AndesRobot-Oficial/Structure-Embedded-Systems_MILO/milo_description/meshes/hoverboard_mainboard_verde.stl

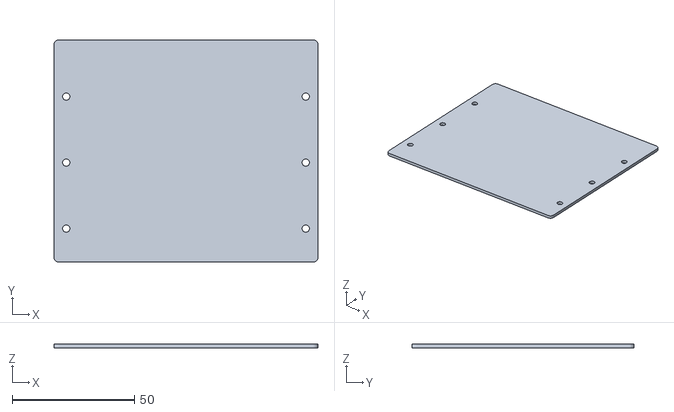
[picture p1: CAD file, 2026-11-08]
milo_description/meshes/hoverboard_mainboard_verde.stl
108.0 x 91.0 x 1.50
