AndesRobot-Oficial/Structure-Embedded-Systems_MILO/milo_description/meshes/hoverboard_mainboard_gris.stl

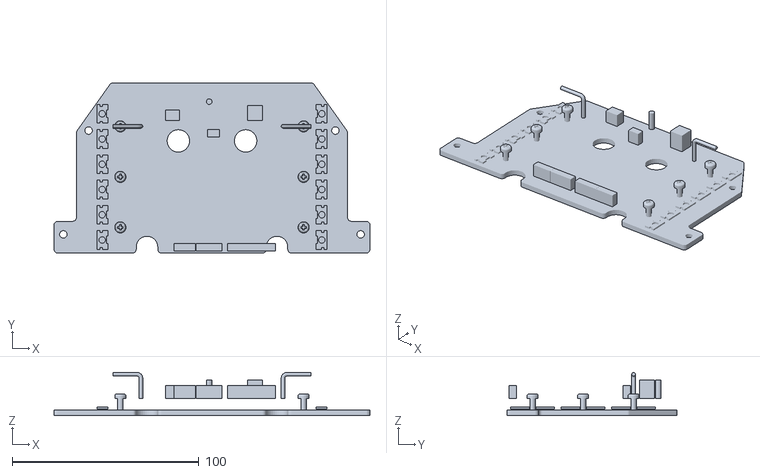
[picture p2: CAD file, 2026-11-08]
milo_description/meshes/hoverboard_mainboard_gris.stl
169.0 x 91.0 x 23.0
