AndesRobot-Oficial/Structure-Embedded-Systems_MILO/milo_description/meshes/hoverboard_mainboard_azul.stl

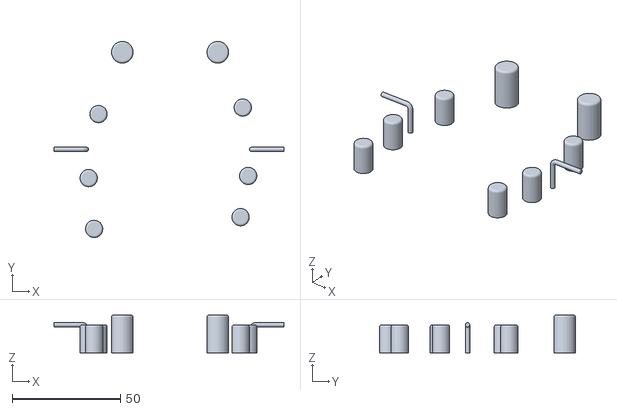
[picture p3: CAD file, 2026-11-08]
milo_description/meshes/hoverboard_mainboard_azul.stl
106.0 x 90.4 x 17.5
