AndesRobot-Oficial/Structure-Embedded-Systems_MILO/milo_description/meshes/hoverboard_mainboard_negro.stl

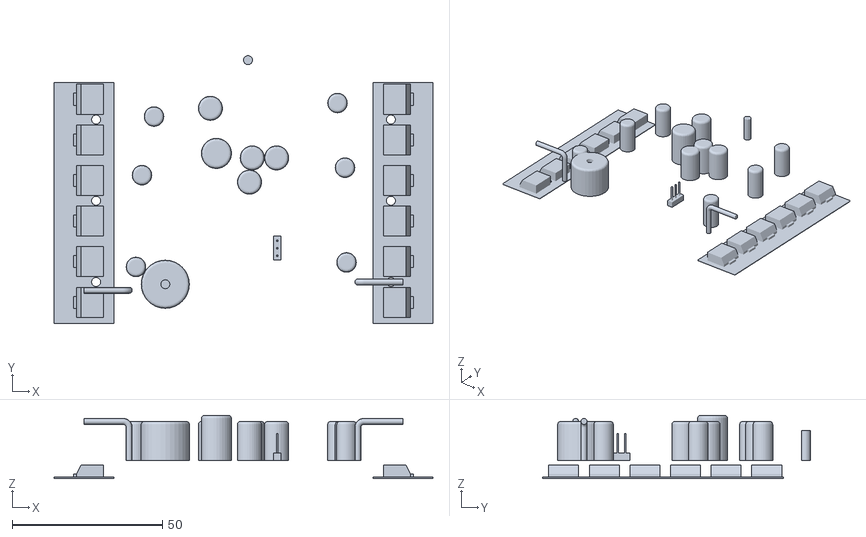
[picture p4: CAD file, 2026-11-08]
milo_description/meshes/hoverboard_mainboard_negro.stl
126.0 x 89.0 x 21.0
