AndesRobot-Oficial/Structure-Embedded-Systems_MILO/milo_description/meshes/cabeza_carcasa.stl

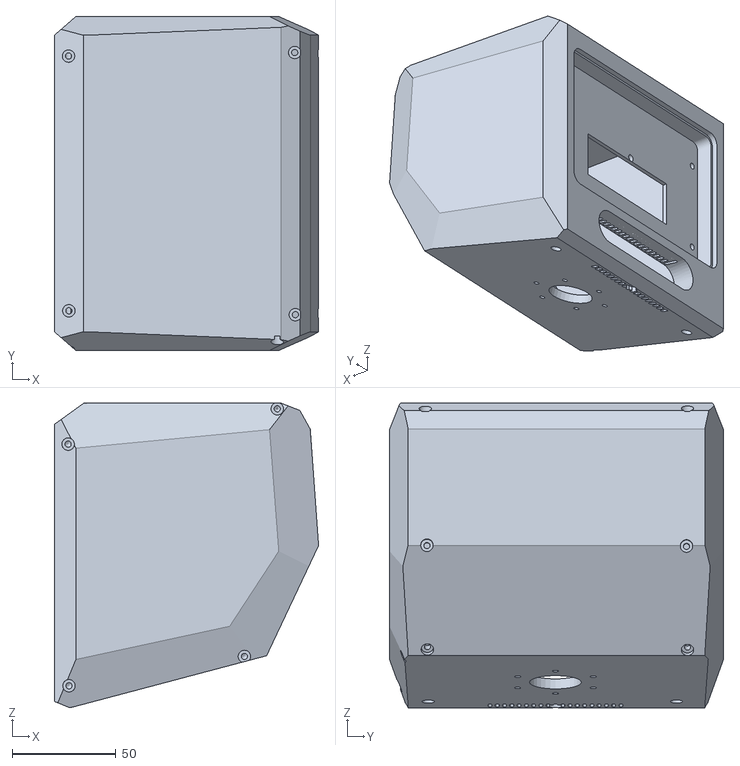
[picture p5: CAD file, 2026-11-08]
milo_description/meshes/cabeza_carcasa.stl
127.1 x 160.7 x 146.6
