AndesRobot-Oficial/Structure-Embedded-Systems_MILO/milo_description/meshes/sk16.stl

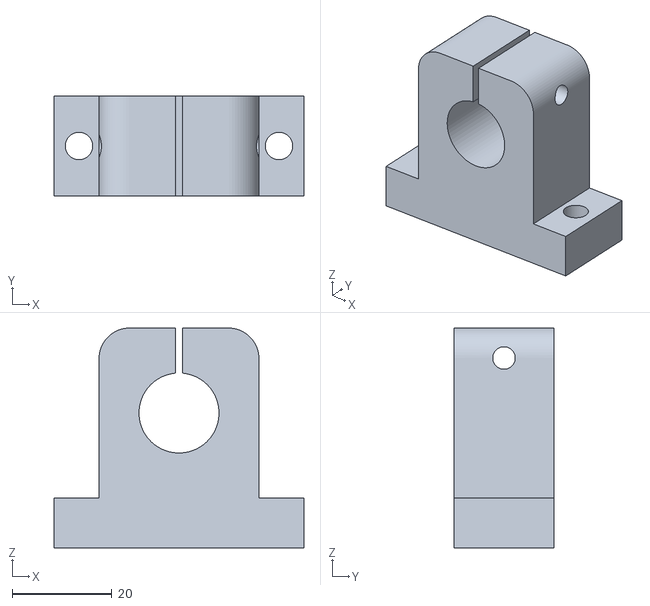
[picture p6: CAD file, 2026-11-08]
milo_description/meshes/sk16.stl
50.0 x 20.0 x 44.0
