AndesRobot-Oficial/Structure-Embedded-Systems_MILO/milo_description/meshes/bateria_izq_dorado.stl

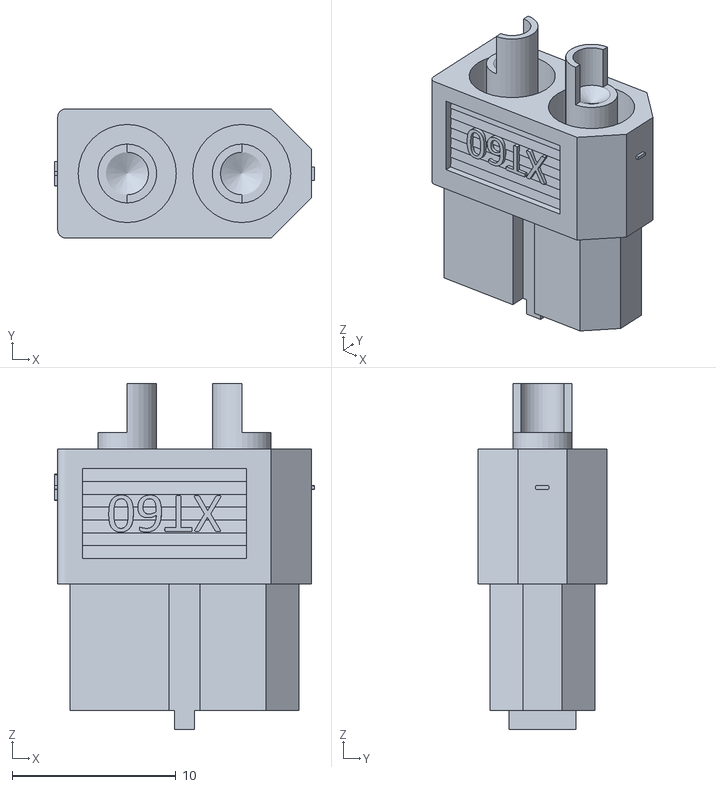
[picture p7: CAD file, 2026-11-08]
milo_description/meshes/bateria_izq_dorado.stl
15.9 x 7.90 x 21.2
