AndesRobot-Oficial/Structure-Embedded-Systems_MILO/milo_description/meshes/bateria_izq_azul.stl

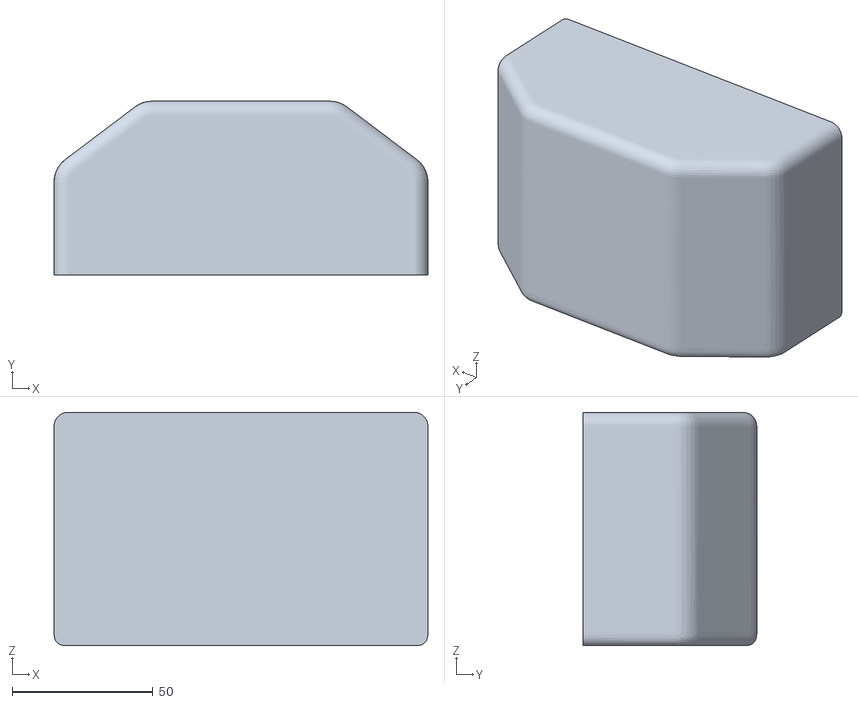
[picture p8: CAD file, 2026-11-08]
milo_description/meshes/bateria_izq_azul.stl
133.0 x 61.8 x 83.0
