AndesRobot-Oficial/Structure-Embedded-Systems_MILO/milo_description/meshes/imu_hfi_b9_cuerpo.stl

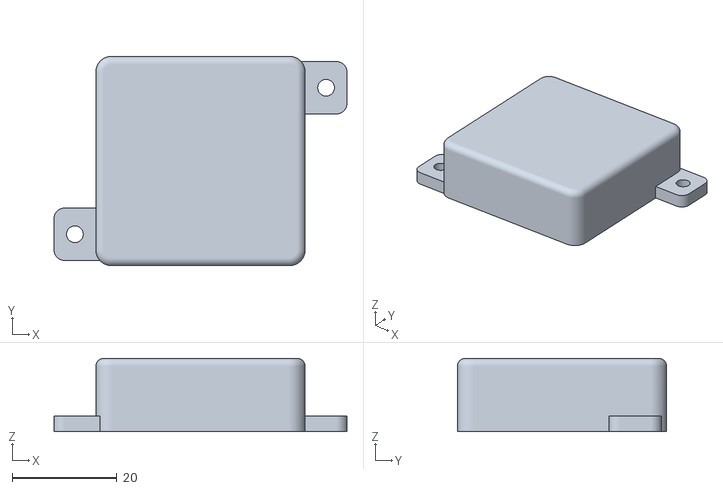
[picture p9: CAD file, 2026-11-08]
milo_description/meshes/imu_hfi_b9_cuerpo.stl
56.0 x 40.0 x 14.0
