AndesRobot-Oficial/Structure-Embedded-Systems_MILO/milo_description/meshes/monitor_soporte.stl

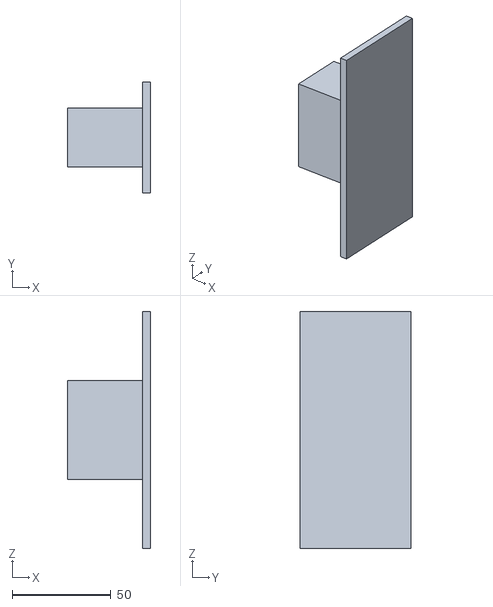
[picture p10: CAD file, 2026-11-08]
milo_description/meshes/monitor_soporte.stl
42.0 x 56.0 x 120.0
