AndesRobot-Oficial/Structure-Embedded-Systems_MILO/milo_description/meshes/arduino_mega_pcb.stl

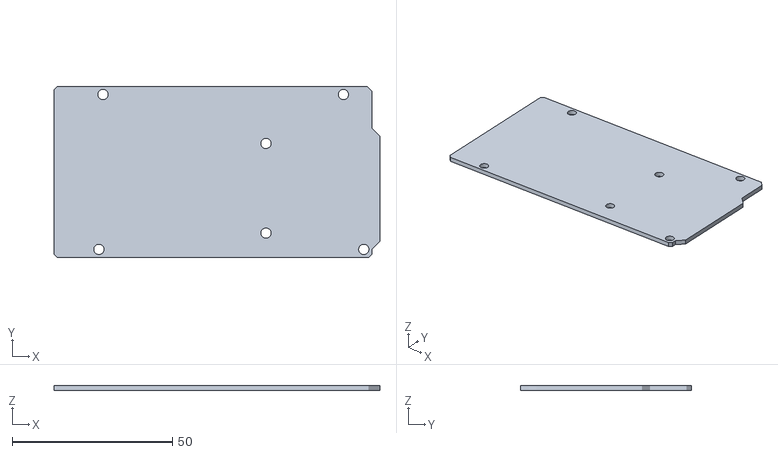
[picture p11: CAD file, 2026-11-08]
milo_description/meshes/arduino_mega_pcb.stl
101.6 x 53.3 x 1.60
