AndesRobot-Oficial/Structure-Embedded-Systems_MILO/milo_description/meshes/bateria_izq_negro.stl

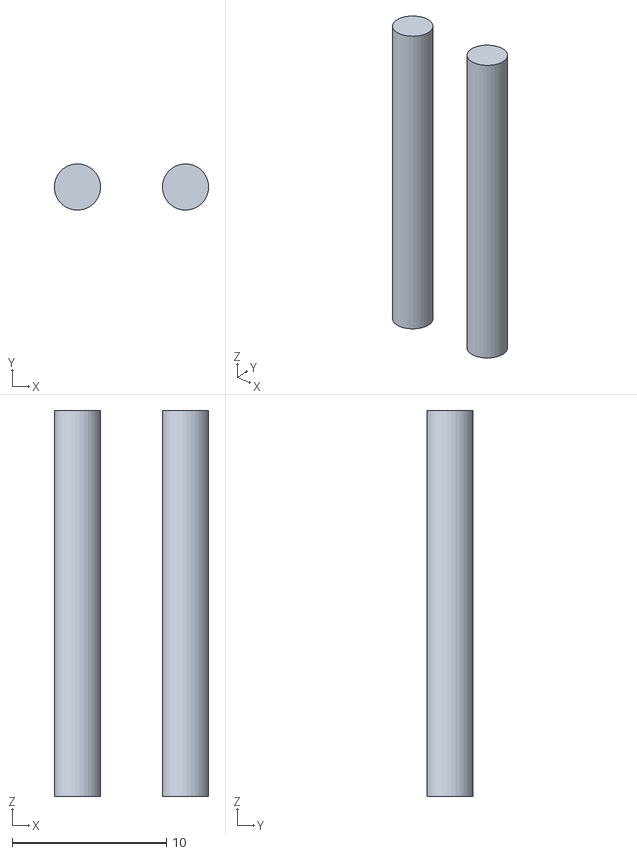
[picture p12: CAD file, 2026-11-08]
milo_description/meshes/bateria_izq_negro.stl
9.99 x 3.00 x 25.0
