AndesRobot-Oficial/Structure-Embedded-Systems_MILO/milo_description/meshes/cabeza_realsense_d435.stl

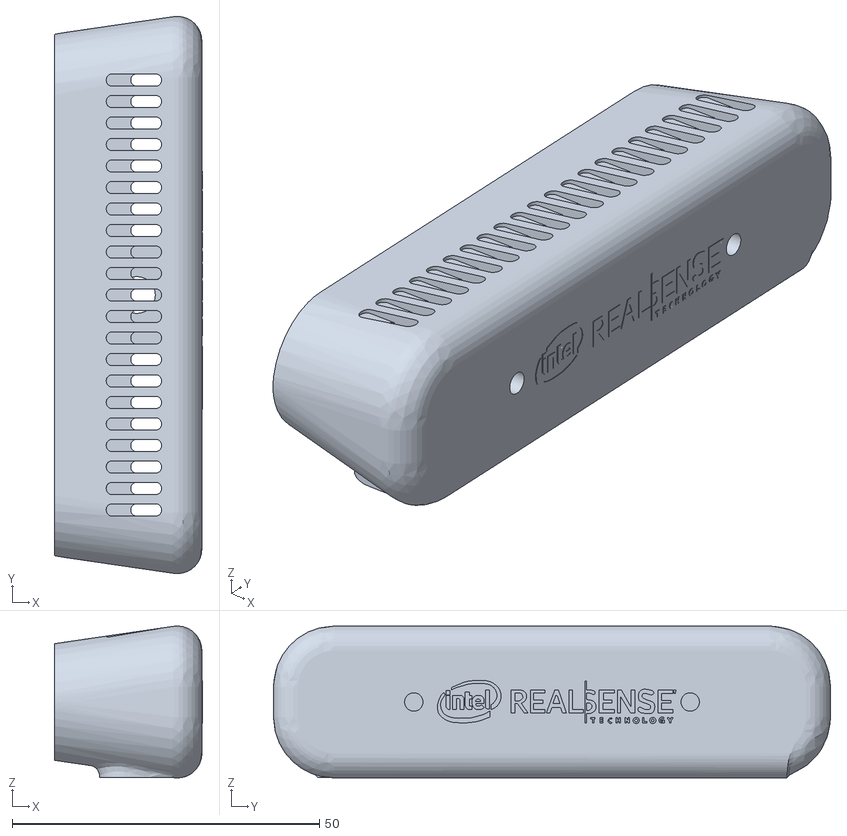
[picture p13: CAD file, 2026-11-08]
milo_description/meshes/cabeza_realsense_d435.stl
24.1 x 90.7 x 24.7
