AndesRobot-Oficial/Structure-Embedded-Systems_MILO/milo_description/meshes/jetson_orin_nano_azul.stl

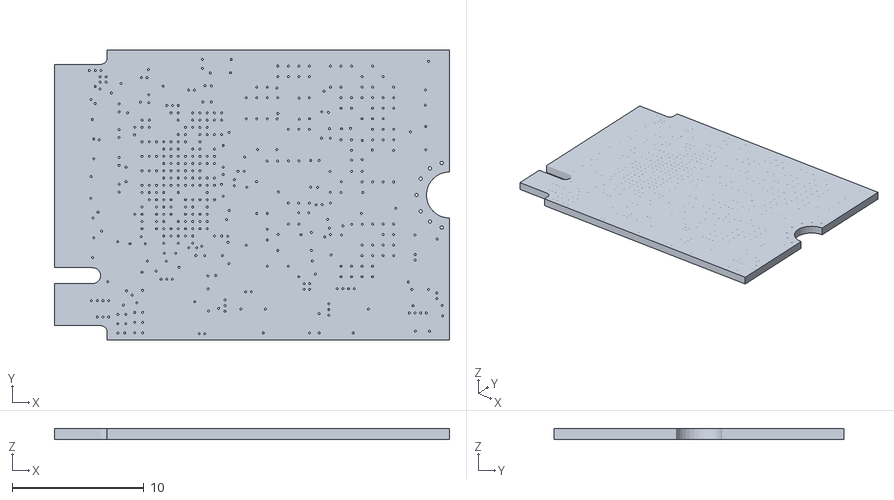
[picture p14: CAD file, 2026-11-08]
milo_description/meshes/jetson_orin_nano_azul.stl
30.0 x 22.0 x 0.8
