AndesRobot-Oficial/Structure-Embedded-Systems_MILO/milo_description/meshes/rueda_loca_nucleo.stl

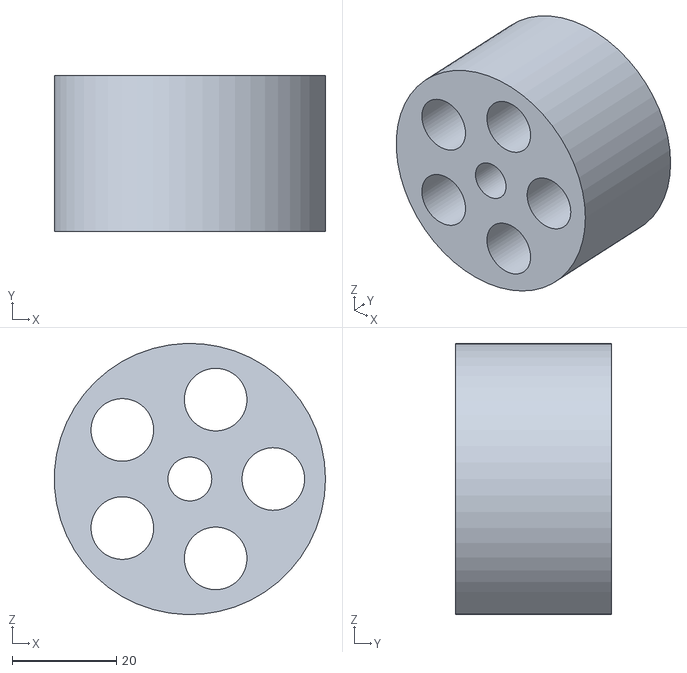
[picture p15: CAD file, 2026-11-08]
milo_description/meshes/rueda_loca_nucleo.stl
52.0 x 30.0 x 52.0
