AndesRobot-Oficial/Structure-Embedded-Systems_MILO/milo_description/meshes/rplidar_c1.stl

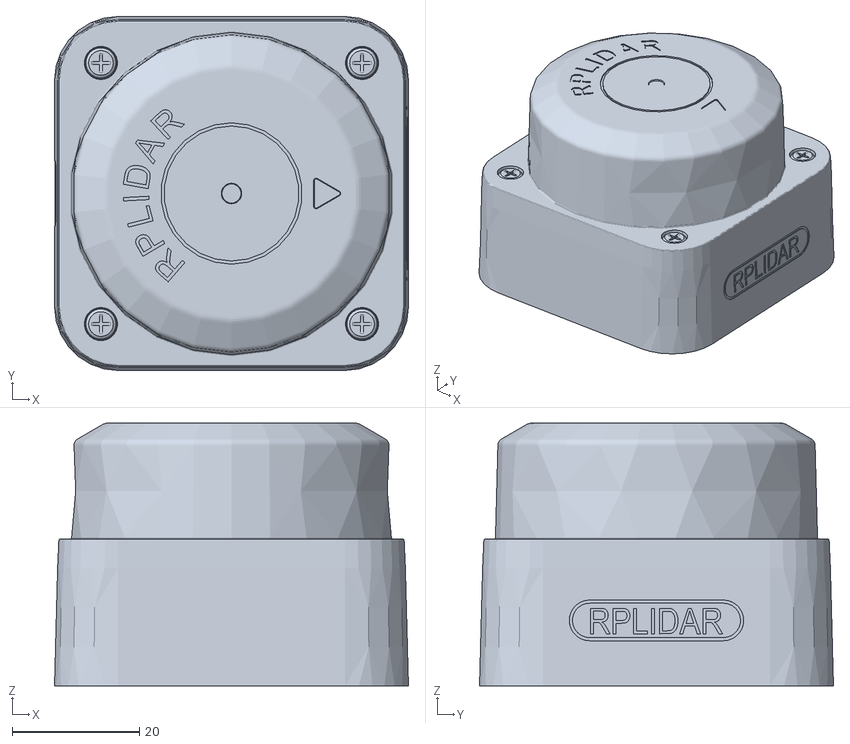
[picture p16: CAD file, 2026-11-08]
milo_description/meshes/rplidar_c1.stl
55.6 x 55.6 x 41.3
