AndesRobot-Oficial/Structure-Embedded-Systems_MILO/milo_description/meshes/rueda_hoverboard_6_5.stl

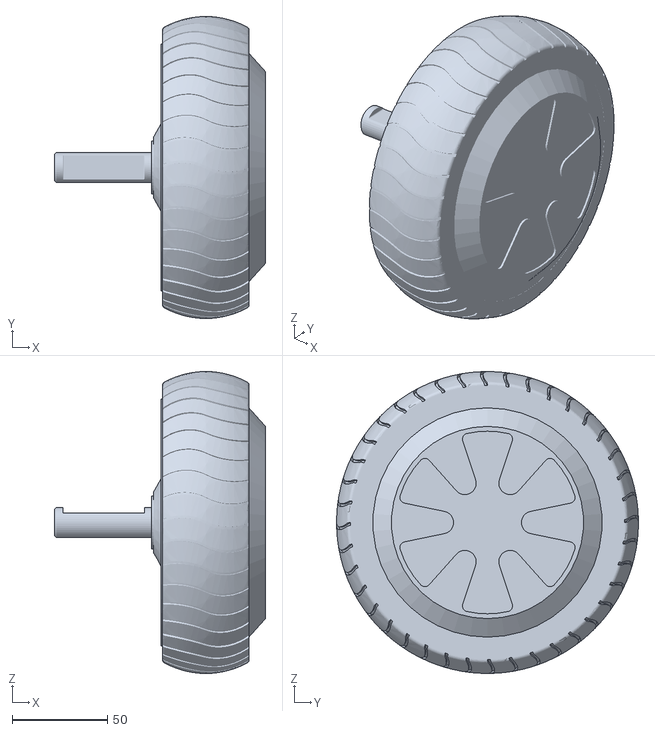
[picture p17: CAD file, 2026-11-08]
milo_description/meshes/rueda_hoverboard_6_5.stl
111.0 x 158.7 x 158.7
