AndesRobot-Oficial/Structure-Embedded-Systems_MILO/milo_description/meshes/tapa_6060.stl

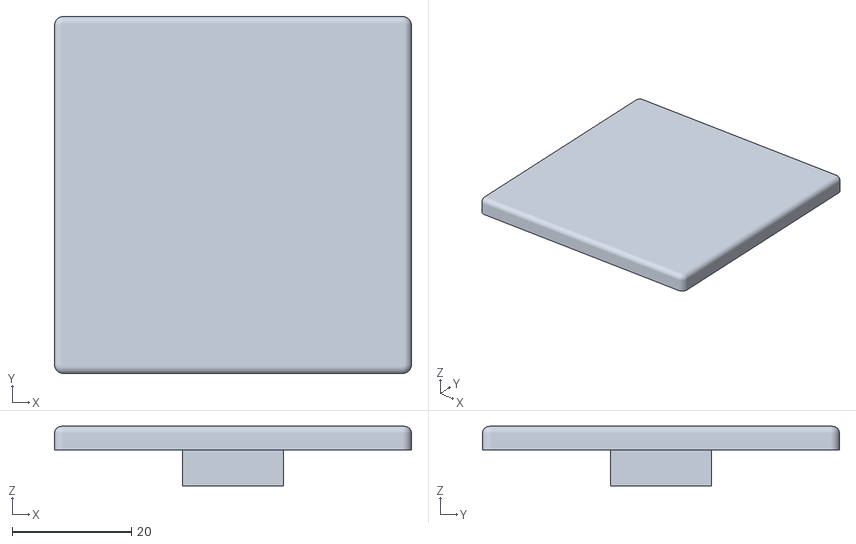
[picture p18: CAD file, 2026-11-08]
milo_description/meshes/tapa_6060.stl
60.0 x 60.0 x 10.0
