AndesRobot-Oficial/Structure-Embedded-Systems_MILO/milo_description/meshes/jetson_orin_nano_gris.stl

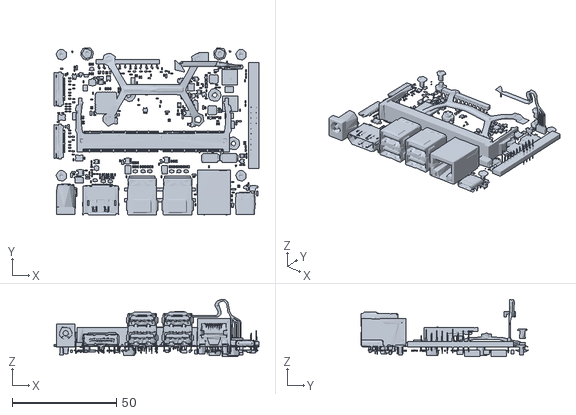
[picture p19: CAD file, 2026-11-08]
milo_description/meshes/jetson_orin_nano_gris.stl
98.2 x 80.1 x 27.5
