AndesRobot-Oficial/Structure-Embedded-Systems_MILO/milo_description/meshes/monitor_cuerpo.stl

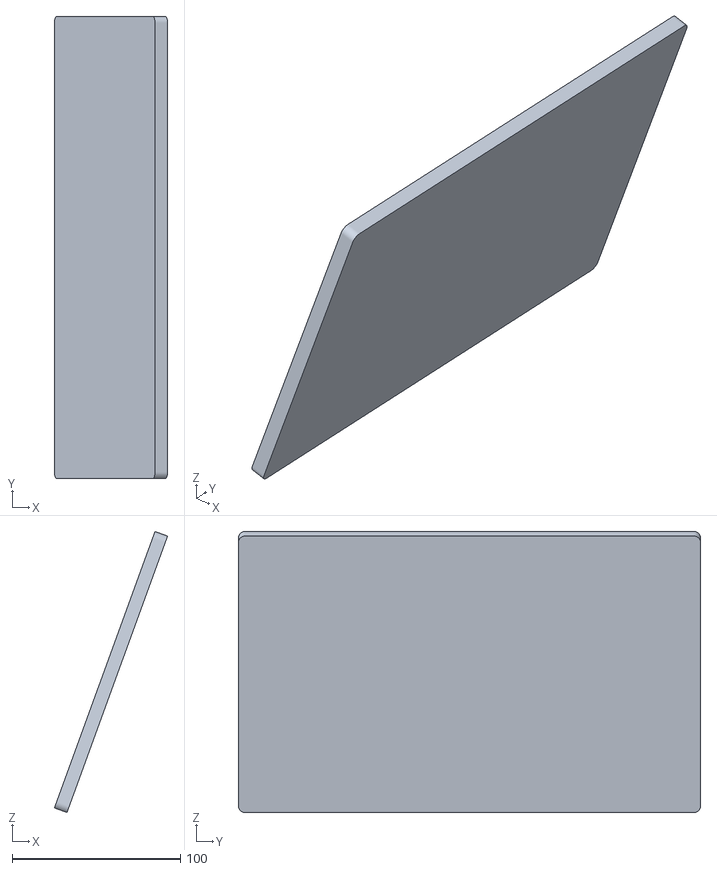
[picture p20: CAD file, 2026-11-08]
milo_description/meshes/monitor_cuerpo.stl
67.4 x 275.0 x 167.2
