AndesRobot-Oficial/Structure-Embedded-Systems_MILO/milo_description/meshes/jetson_orin_nano_verde.stl

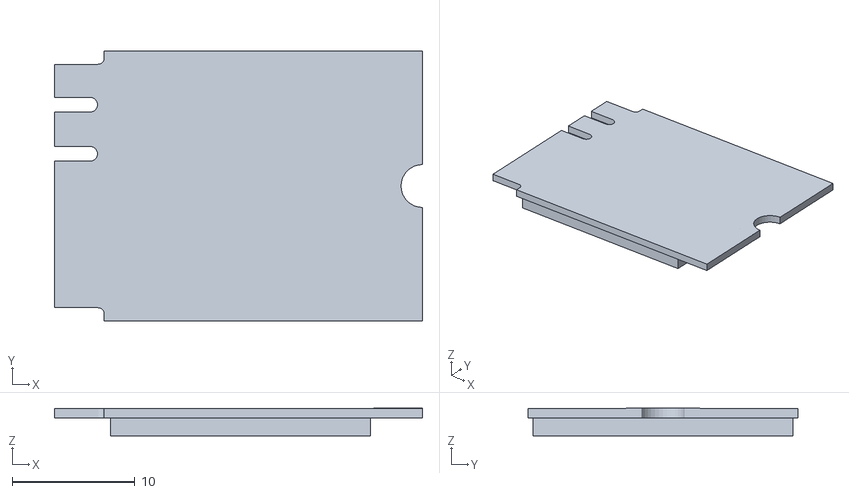
[picture p21: CAD file, 2026-11-08]
milo_description/meshes/jetson_orin_nano_verde.stl
30.0 x 22.0 x 2.26
