AndesRobot-Oficial/Structure-Embedded-Systems_MILO/milo_description/meshes/imu_hfi_b9_conector.stl

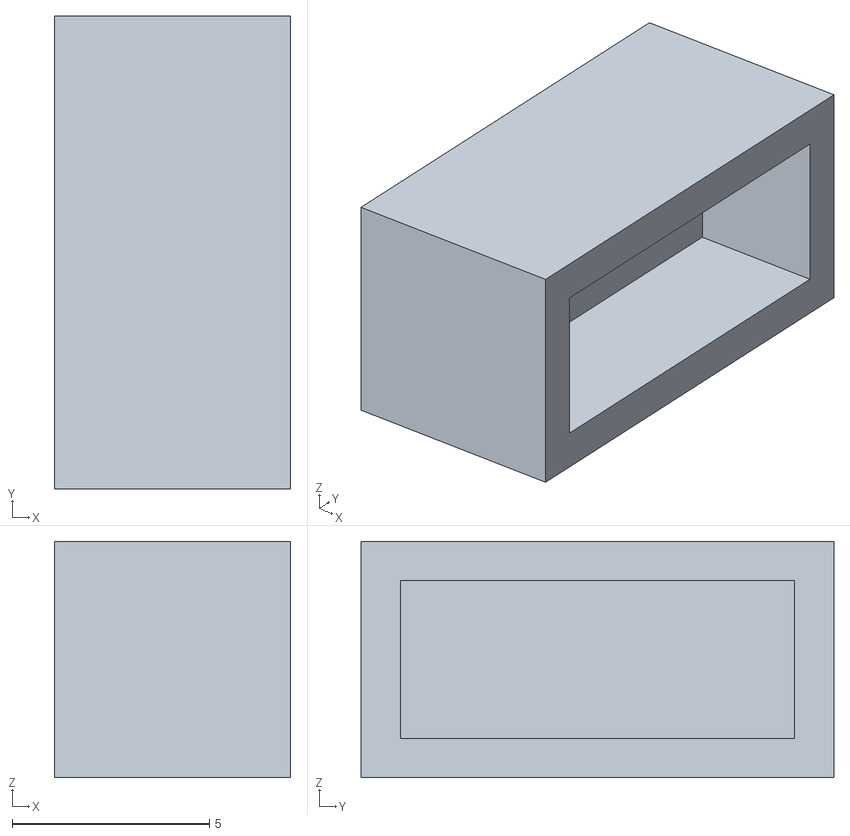
[picture p22: CAD file, 2026-11-08]
milo_description/meshes/imu_hfi_b9_conector.stl
6.00 x 12.0 x 6.00
