AndesRobot-Oficial/Structure-Embedded-Systems_MILO/milo_description/meshes/rueda_loca_acero.stl

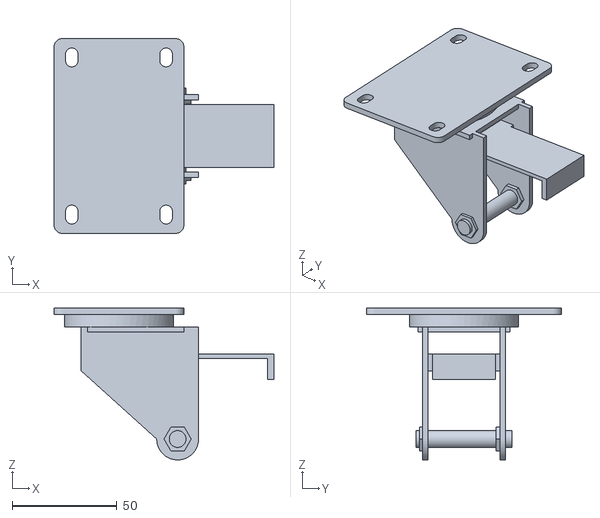
[picture p23: CAD file, 2026-11-08]
milo_description/meshes/rueda_loca_acero.stl
105.0 x 93.0 x 72.5
