AndesRobot-Oficial/Structure-Embedded-Systems_MILO/milo_description/meshes/arduino_mega_negro.stl

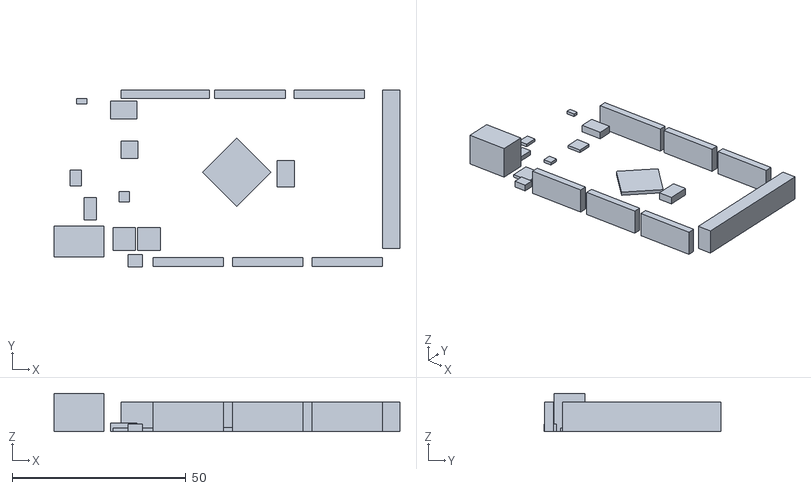
[picture p24: CAD file, 2026-11-08]
milo_description/meshes/arduino_mega_negro.stl
99.6 x 51.1 x 11.0
