AndesRobot-Oficial/Structure-Embedded-Systems_MILO/milo_description/meshes/vslot_6060_1m.stl

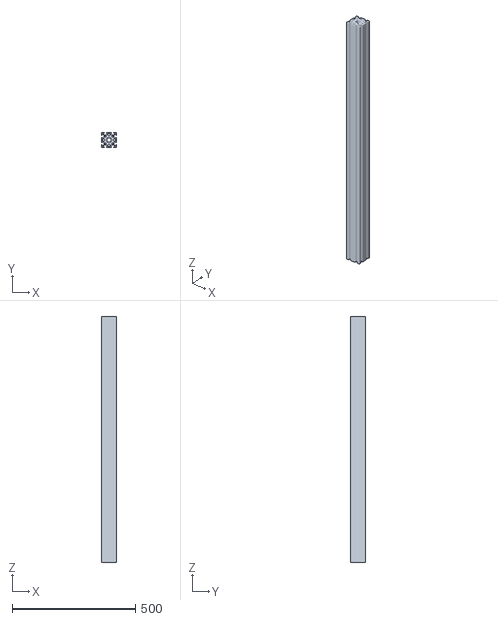
[picture p25: CAD file, 2026-11-08]
milo_description/meshes/vslot_6060_1m.stl
60.0 x 60.0 x 1000.0
