AndesRobot-Oficial/Structure-Embedded-Systems_MILO/milo_description/meshes/monitor_pantalla.stl

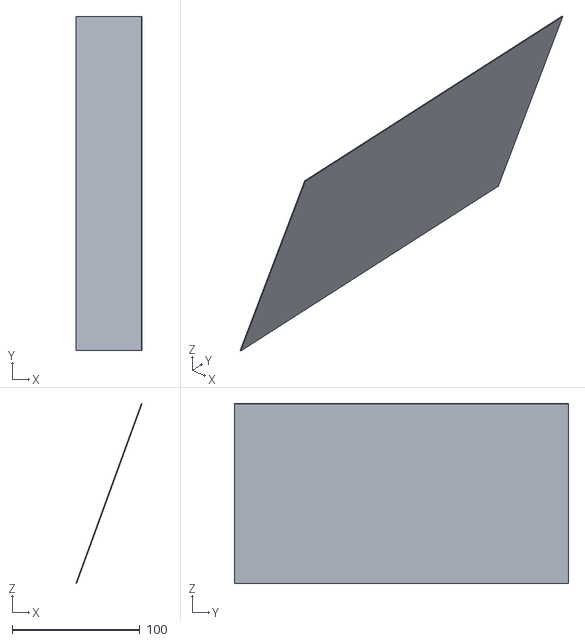
[picture p26: CAD file, 2026-11-08]
milo_description/meshes/monitor_pantalla.stl
51.9 x 262.0 x 141.2
