AndesRobot-Oficial/Structure-Embedded-Systems_MILO/milo_description/meshes/regulador_36v_12v.stl

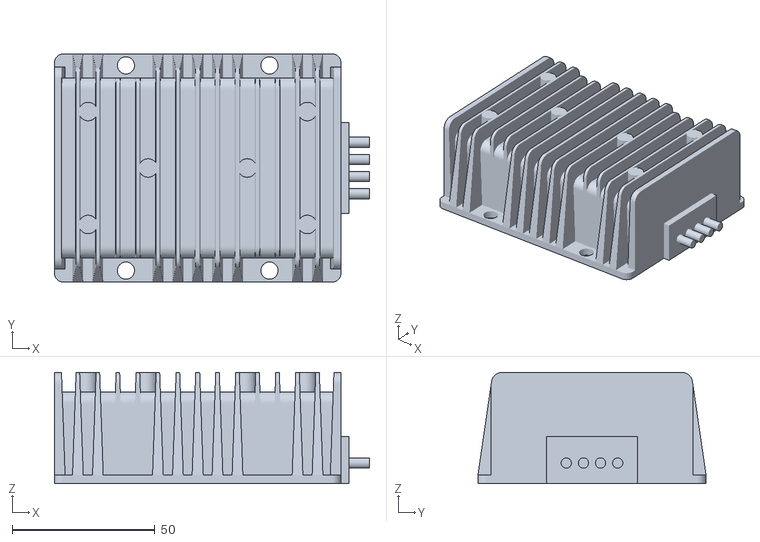
[picture p27: CAD file, 2026-11-08]
milo_description/meshes/regulador_36v_12v.stl
110.2 x 79.8 x 39.0
