AndesRobot-Oficial/Structure-Embedded-Systems_MILO/milo_description/meshes/tb6600_negro.stl

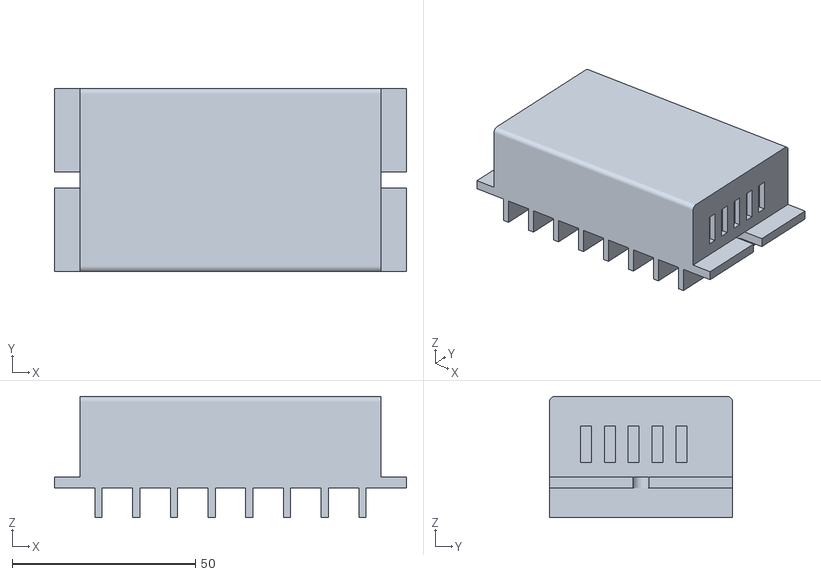
[picture p28: CAD file, 2026-11-08]
milo_description/meshes/tb6600_negro.stl
96.0 x 50.0 x 33.0
