AndesRobot-Oficial/Structure-Embedded-Systems_MILO/milo_description/meshes/rueda_loca_pu.stl

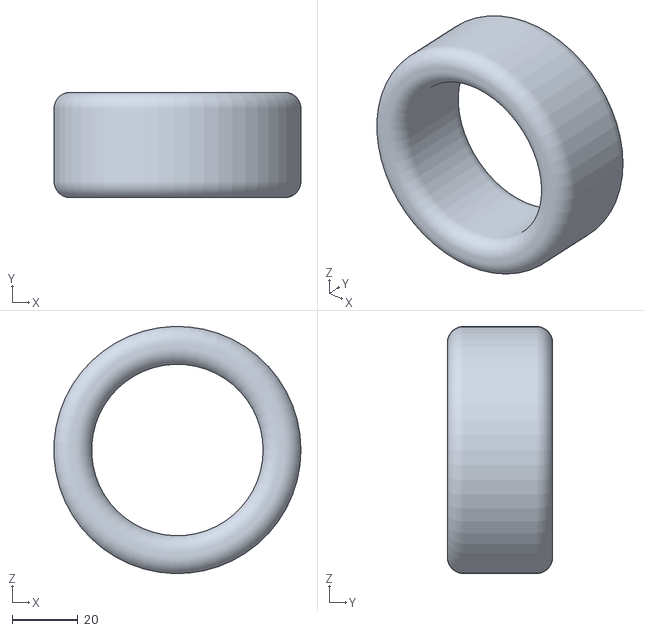
[picture p29: CAD file, 2026-11-08]
milo_description/meshes/rueda_loca_pu.stl
74.9 x 32.0 x 75.0
