AndesRobot-Oficial/Structure-Embedded-Systems_MILO/milo_description/meshes/jetson_orin_nano_negro.stl

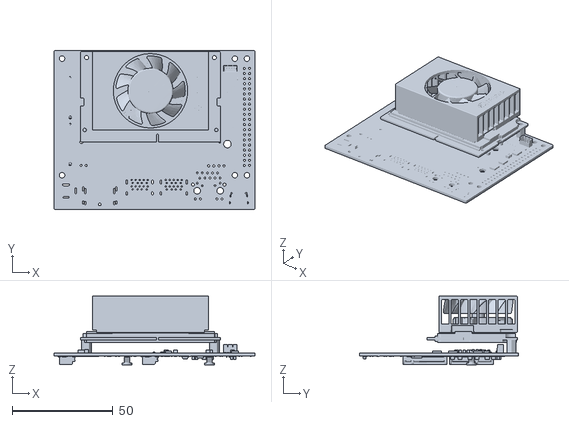
[picture p30: CAD file, 2026-11-08]
milo_description/meshes/jetson_orin_nano_negro.stl
100.0 x 79.0 x 34.2
