AndesRobot-Oficial/Structure-Embedded-Systems_MILO/milo_description/meshes/cabeza_pantalla_vidrio.stl

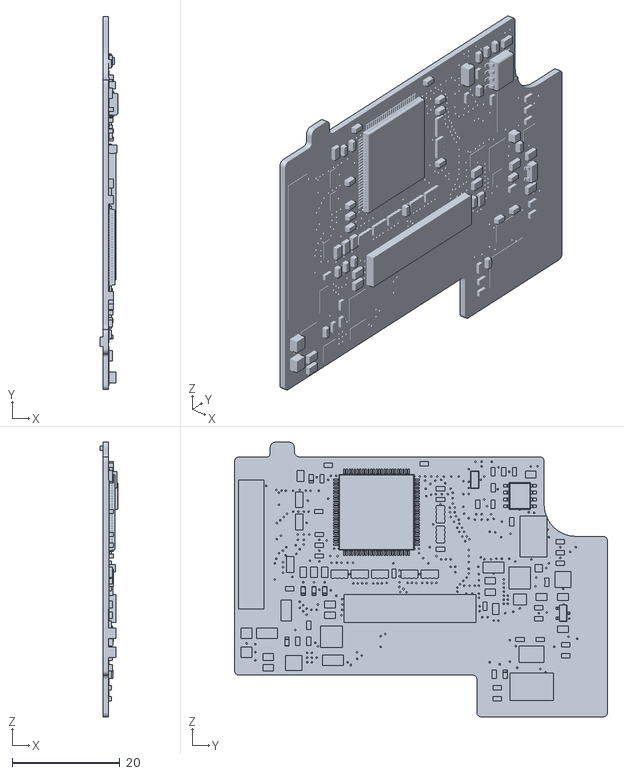
[picture p31: CAD file, 2026-11-08]
milo_description/meshes/cabeza_pantalla_vidrio.stl
3.35 x 69.3 x 51.0
