AndesRobot-Oficial/Structure-Embedded-Systems_MILO/milo_description/meshes/vslot_3030_1m.stl

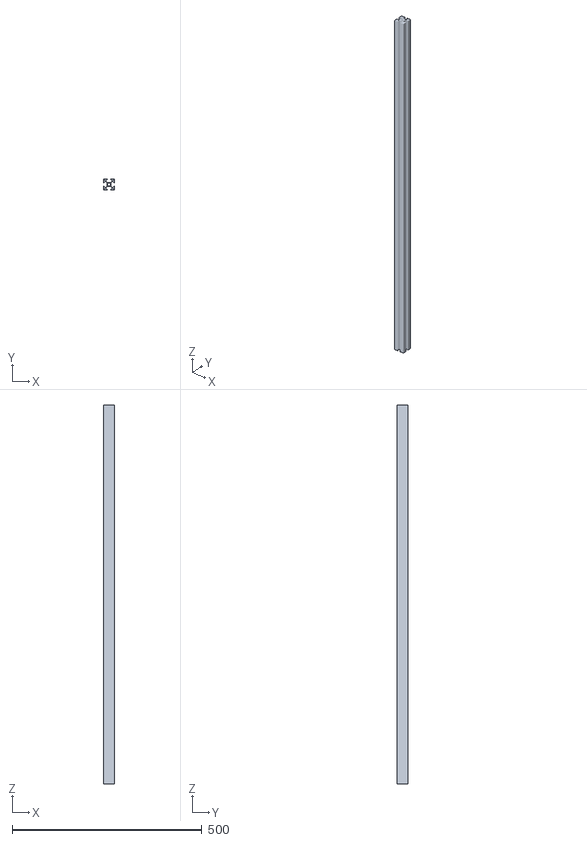
[picture p32: CAD file, 2026-11-08]
milo_description/meshes/vslot_3030_1m.stl
30.0 x 30.0 x 1000.0
