AndesRobot-Oficial/Structure-Embedded-Systems_MILO/milo_description/meshes/tb6600_verde.stl

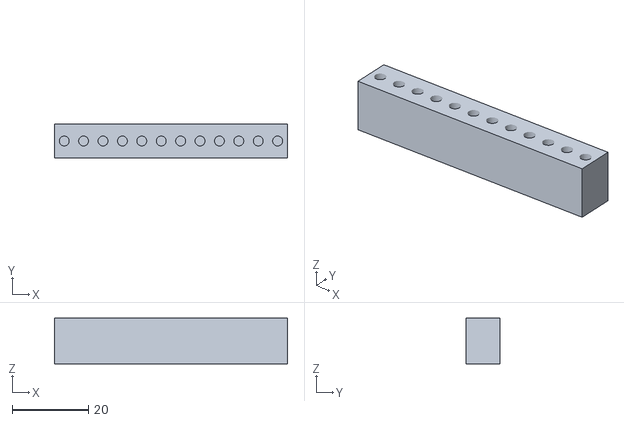
[picture p33: CAD file, 2026-11-08]
milo_description/meshes/tb6600_verde.stl
61.0 x 9.00 x 12.0
