AndesRobot-Oficial/Structure-Embedded-Systems_MILO/milo_description/meshes/tb6600_rojo.stl

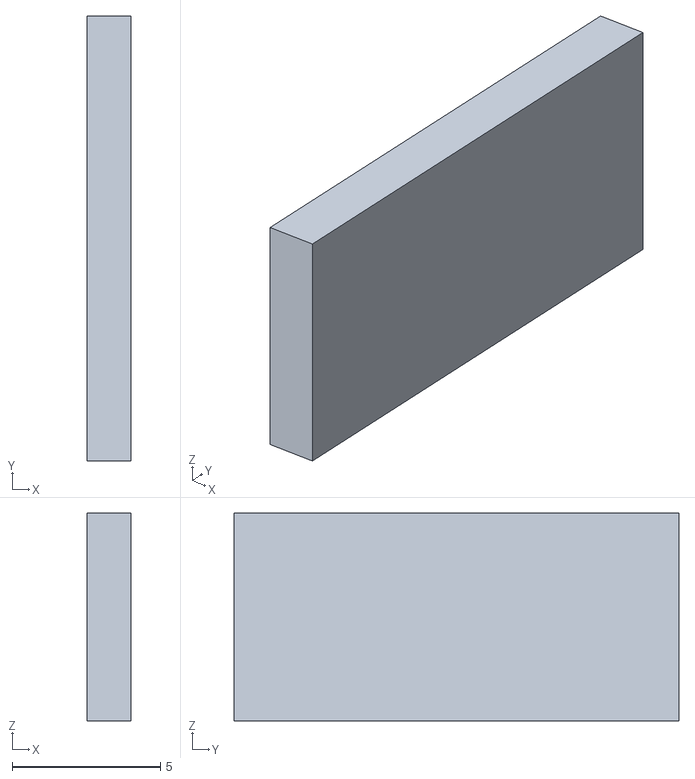
[picture p34: CAD file, 2026-11-08]
milo_description/meshes/tb6600_rojo.stl
1.50 x 15.0 x 7.00
