AndesRobot-Oficial/Structure-Embedded-Systems_MILO/milo_description/meshes/cabeza_pantalla_marco.stl

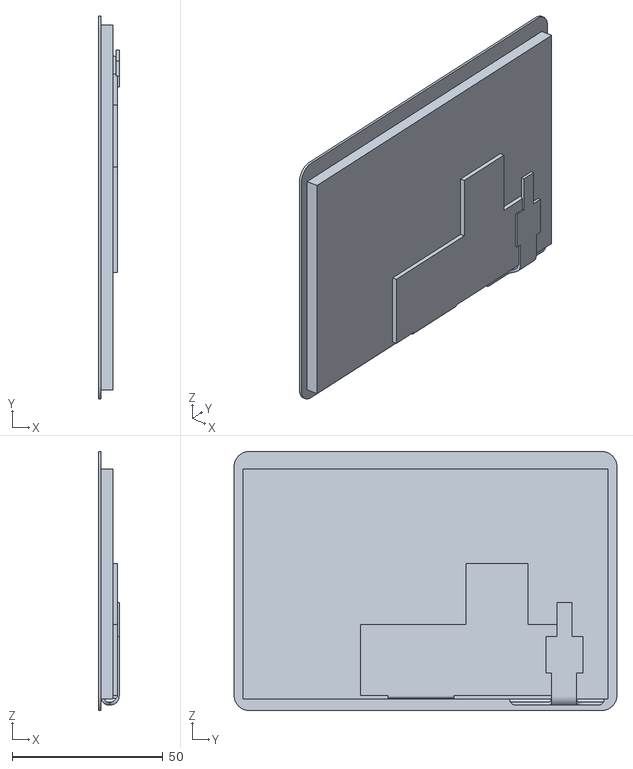
[picture p35: CAD file, 2026-11-08]
milo_description/meshes/cabeza_pantalla_marco.stl
6.80 x 127.0 x 85.9
