AndesRobot-Oficial/Structure-Embedded-Systems_MILO/milo_description/meshes/arduino_mega_metal.stl

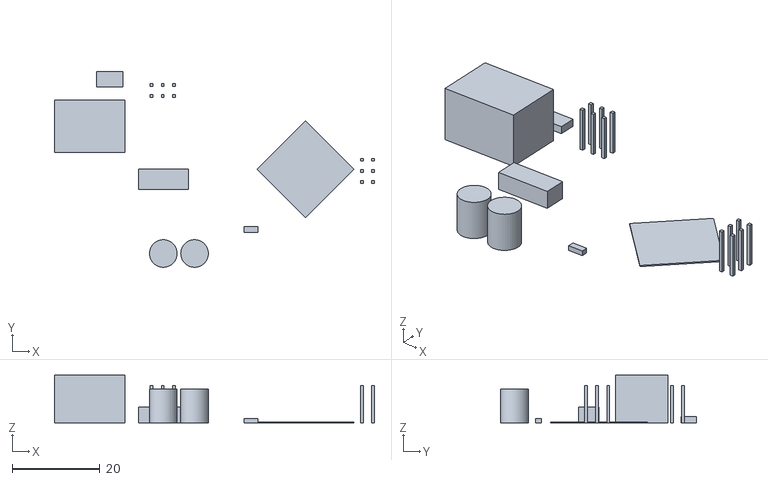
[picture p36: CAD file, 2026-11-08]
milo_description/meshes/arduino_mega_metal.stl
72.8 x 44.5 x 10.9
