AndesRobot-Oficial/Structure-Embedded-Systems_MILO/milo_description/meshes/escuadra_3030.stl

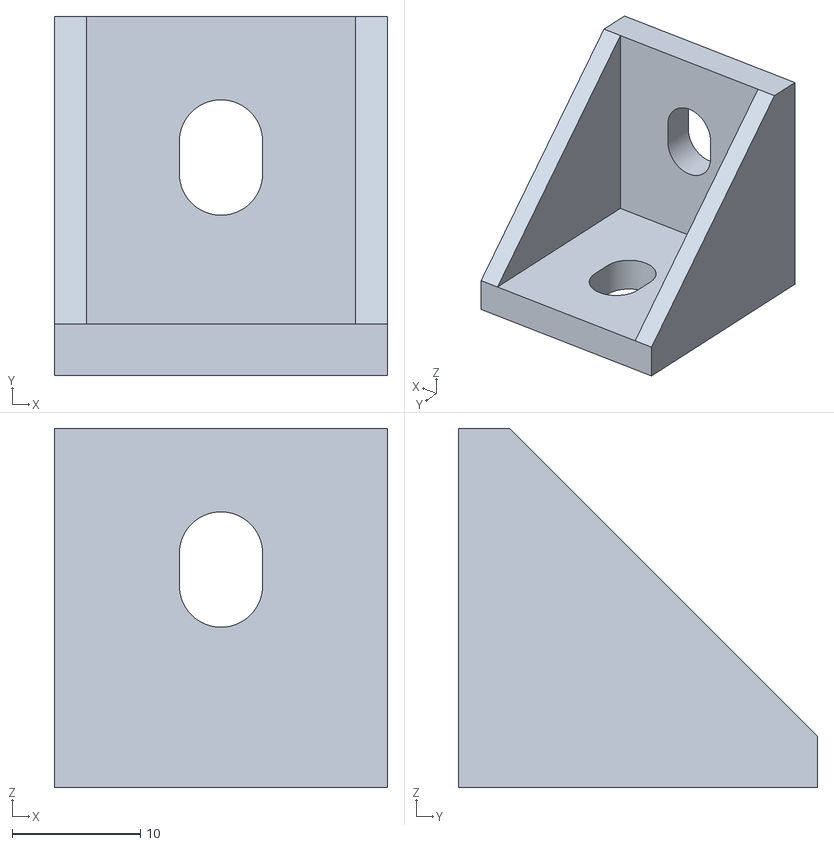
[picture p37: CAD file, 2026-11-08]
milo_description/meshes/escuadra_3030.stl
26.0 x 28.0 x 28.0
