AndesRobot-Oficial/Structure-Embedded-Systems_MILO/milo_description/meshes/orbbec_gemini_plus.stl

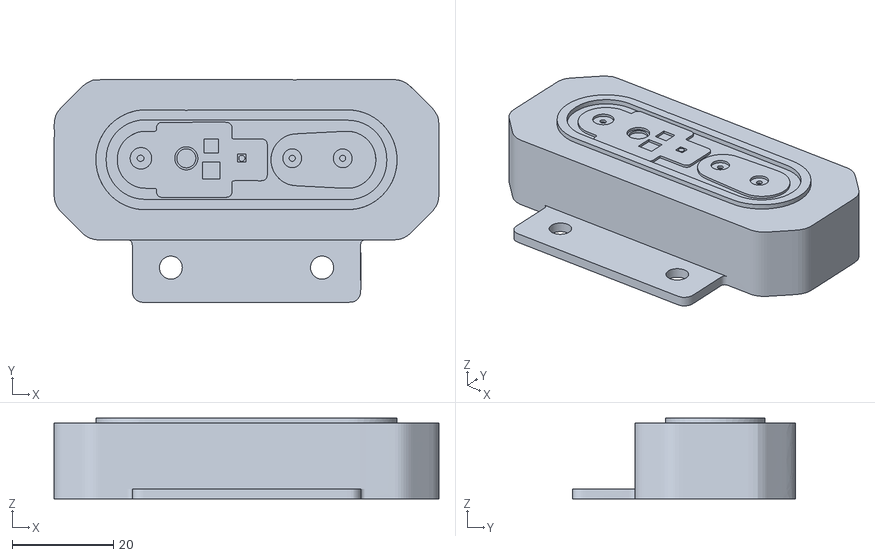
[picture p38: CAD file, 2026-11-08]
milo_description/meshes/orbbec_gemini_plus.stl
76.0 x 44.0 x 15.9
