AndesRobot-Oficial/Structure-Embedded-Systems_MILO/milo_description/meshes/acrilico_base.stl

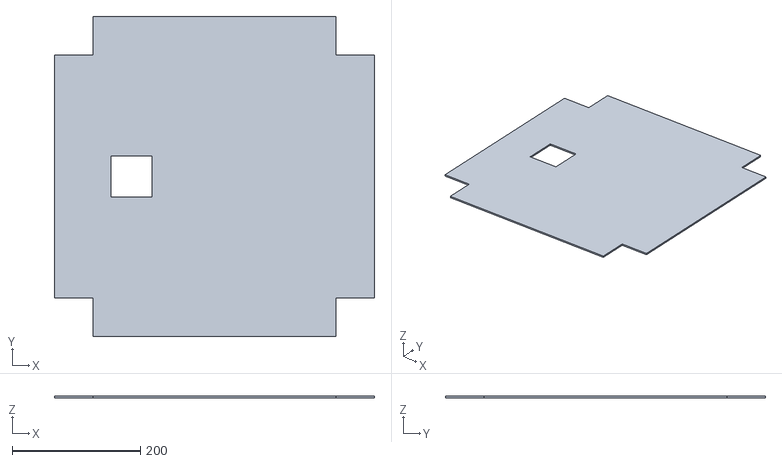
[picture p39: CAD file, 2026-11-08]
milo_description/meshes/acrilico_base.stl
500.0 x 500.0 x 3.00
