AndesRobot-Oficial/Structure-Embedded-Systems_MILO/milo_description/meshes/jetson_orin_nano_dorado.stl

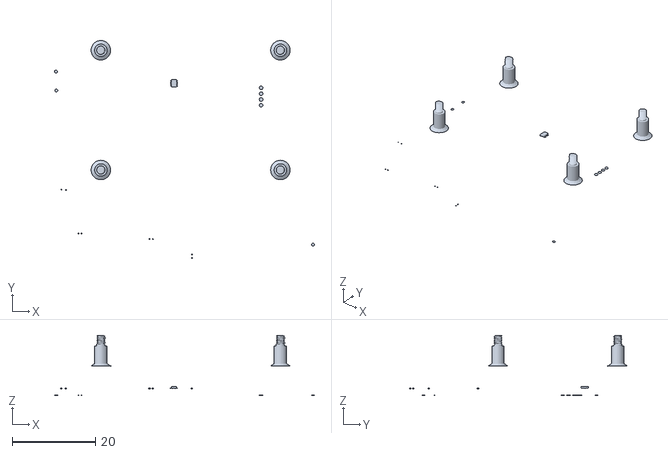
[picture p40: CAD file, 2026-11-08]
milo_description/meshes/jetson_orin_nano_dorado.stl
62.6 x 52.4 x 14.4
