AndesRobot-Oficial/Structure-Embedded-Systems_MILO/(list of files, cad)

Other CAD files:
cad/milo_ensamblaje.step
milo_description/meshes/bateria_der_azul.stl
milo_description/meshes/bateria_der_negro.stl
milo_description/meshes/bateria_der_dorado.stl
cad/milo_ensamblaje.f3z
