AndesRobot-Oficial/Structure-Embedded-Systems_MILO/milo_description/urdf/andesrobot.urdf.xacro

<?xml version="1.0" ?>
<robot name="andesrobot" xmlns:xacro="http://www.ros.org/wiki/xacro">

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
<xacro:include filename="$(find andesrobot_description)/urdf/andesrobot.materials.xacro" />
<xacro:include filename="$(find andesrobot_description)/urdf/andesrobot.gazebo.xacro" />

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
<xacro:arg name="lock_arm" default="false"/>
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
<xacro:property name="lock_arm" value="${'$(arg lock_arm)' == 'true'}"/>
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
<xacro:property name="arm_joint_type" value="${'fixed' if lock_arm else 'revolute'}"/>
<xacro:property name="prismatic_joint_type" value="${'fixed' if lock_arm else 'prismatic'}"/>

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
<xacro:arg name="simple_collision" default="false"/>
<xacro:property name="simple_collision" value="${'$(arg simple_collision)' == 'true'}"/>
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
<xacro:arg name="arm_control" default="false"/>
<xacro:property name="arm_control" value="${'$(arg arm_control)' == 'true'}"/>
<xacro:arg name="arm_controllers_file" default=""/>
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
<xacro:arg name="sim_lidar" default="true"/>
<xacro:arg name="sim_imu" default="true"/>
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
  <link name="base_footprint"/>
  <joint name="base_footprint_joint" type="fixed">
    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
    <origin rpy="0 0 0" xyz="0 0 0.08935"/>
    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
    <parent link="base_footprint"/>
    <child link="base_link"/>
  </joint>
  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
  <link name="base_link">
    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
    <inertial>
      <origin rpy="0 0 0" xyz="0.1026 0.0000 0.1278"/>
      <mass value="5.8118"/>
      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
    </inertial>
    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
    <xacro:if value="${simple_collision}">
    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
    </xacro:if>
  </link>
  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
  <link name="link_1_1">
    <inertial>
      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
      <origin rpy="0 0 0" xyz="-0.01311 0.00001 0.06439"/>
      <mass value="0.3801"/>
      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
    </inertial>
    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
    <xacro:unless value="${simple_collision}">
    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
    </xacro:unless>
  </link>
  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
  <link name="link_2_1">
    <inertial>
      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
      <origin rpy="0 0 0" xyz="-0.06166 0.00004 0.17377"/>
      <mass value="1.1570"/>
      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
    </inertial>
    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
    <xacro:unless value="${simple_collision}">
    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
    </xacro:unless>
  </link>
  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
  <link name="link_3_1">
    <inertial>
      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
      <origin rpy="0 0 0" xyz="0.06132 -0.00001 0.14817"/>
      <mass value="0.6736"/>
      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
    </inertial>
    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
    <xacro:unless value="${simple_collision}">
    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
    </xacro:unless>
  </link>
  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
  <link name="link_4_1">
    <inertial>
      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
      <origin rpy="0 0 0" xyz="-0.04027 -0.00001 -0.01026"/>
      <mass value="0.1972"/>
      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
    </inertial>
    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
    <xacro:unless value="${simple_collision}">
    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
    </xacro:unless>
  </link>
  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
  <link name="link_5_1">
    <inertial>
      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
      <origin rpy="0 0 0" xyz="0.00958 -0.00001 0.04022"/>
      <mass value="0.1964"/>
      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
    </inertial>
    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
    <xacro:unless value="${simple_collision}">
    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
    </xacro:unless>
  </link>
  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
  <link name="link_6_1">
    <inertial>
      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
      <origin rpy="0 0 0" xyz="-0.04402 0.00054 -0.00013"/>
      <mass value="0.0936"/>
      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
    </inertial>
    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
    <xacro:unless value="${simple_collision}">
    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
    </xacro:unless>
  </link>
  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
  <link name="right_finger_link_1">
    <inertial>
      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
      <origin rpy="0 0 0" xyz="-0.02416 0.01348 -0.00710"/>
      <mass value="0.0201"/>
      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
    </inertial>
    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
    <xacro:unless value="${simple_collision}">
    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
    </xacro:unless>
  </link>
  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
  <link name="left_finger_link_1">
    <inertial>
      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
      <origin rpy="0 0 0" xyz="-0.02426 -0.01324 0.00738"/>
      <mass value="0.0201"/>
      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
    </inertial>
    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
    <xacro:unless value="${simple_collision}">
    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
    </xacro:unless>
  </link>
  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
  <link name="lift_carriage_link_1">
    <inertial>
      <origin rpy="0 0 0" xyz="-0.0553571 0 0.0371429"/>
      <mass value="0.8"/>
      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
    </inertial>
    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
    <xacro:unless value="${simple_collision}">
    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
    </xacro:unless>
  </link>
  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
  <xacro:property name="wheel_separation" value="0.3604"/>
  <xacro:property name="wheel_radius" value="0.08255"/>   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
  <xacro:property name="wheel_width" value="0.045"/>      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
  <xacro:property name="wheel_joint_y" value="${wheel_separation/2}"/>
  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
  <link name="left_wheel_link_1">
    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
    <inertial>
      <origin rpy="0 0 0" xyz="0 0 0"/>
      <mass value="3.0000"/>
      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
    </inertial>
    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
  </link>
  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
  <link name="right_wheel_link_1">
    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
    <inertial>
      <origin rpy="0 0 0" xyz="0 0 0"/>
      <mass value="3.0000"/>
      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
    </inertial>
    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
  </link>
  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
  <link name="imu_link_1">
    <inertial>
      <origin rpy="0 0 0" xyz="0 0 0.007"/>
      <mass value="0.02"/>
      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
    </inertial>
    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
  </link>
  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
  <link name="front_caster_link_1">
    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
    <inertial>
      <origin rpy="0 0 0" xyz="0.015 0 -0.045"/>
      <mass value="0.5490"/>
      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
    </inertial>
    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
  </link>
  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
  <link name="lidar_link_1">
    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
    <inertial>
      <origin rpy="0 0 0" xyz="-0.058 0 0.0227"/>
      <mass value="0.11"/>
      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
    </inertial>
    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
  </link>
  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
  <link name="vertical_column_link_1">
    <inertial>
      <origin rpy="0 0 0" xyz="-0.03 0 0.75"/>
      <mass value="3.9"/>
      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
    </inertial>
    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
  </link>
  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
  <link name="arm_base_link_1"/>
  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
  <xacro:property name="arm_lower" value="${-pi}"/>
  <xacro:property name="arm_upper" value="${pi}"/>
  <xacro:property name="arm_effort" value="20.0"/>
  <xacro:property name="arm_velocity" value="1.0"/>
  <xacro:property name="joint_1_lower" value="${arm_lower}"/>   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
  <xacro:property name="joint_1_upper" value="${arm_upper}"/>
  <xacro:property name="joint_2_lower" value="${arm_lower}"/>
  <xacro:property name="joint_2_upper" value="${arm_upper}"/>
  <xacro:property name="joint_3_lower" value="${arm_lower}"/>
  <xacro:property name="joint_3_upper" value="${arm_upper}"/>
  <xacro:property name="joint_4_lower" value="${arm_lower}"/>
  <xacro:property name="joint_4_upper" value="${arm_upper}"/>
  <xacro:property name="joint_5_lower" value="${arm_lower}"/>
  <xacro:property name="joint_5_upper" value="${arm_upper}"/>
  <xacro:property name="joint_6_lower" value="${arm_lower}"/>
  <xacro:property name="joint_6_upper" value="${arm_upper}"/>
  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
  <xacro:macro name="arm_limit" params="lower upper">
    <xacro:unless value="${lock_arm}">
      <limit lower="${lower}" upper="${upper}" effort="${arm_effort}" velocity="${arm_velocity}"/>
    </xacro:unless>
  </xacro:macro>
  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
  <joint name="joint_1" type="${arm_joint_type}">
    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
    <origin rpy="${'0 0 0.2775' if lock_arm else '0 0 0'}" xyz="0.0 0.0 0.0"/>
    <parent link="arm_base_link_1"/>
    <child link="link_1_1"/>
    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
    <axis xyz="0.0 0.0 1.0"/>
    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
    <dynamics damping="0.08" friction="0.02"/>
    <xacro:arm_limit lower="${joint_1_lower}" upper="${joint_1_upper}"/>
  </joint>
  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
  <joint name="joint_2" type="${arm_joint_type}">
    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
    <origin rpy="${'-0.5965 0 0' if lock_arm else '0 0 0'}" xyz="-0.065 0.0 0.056"/>
    <parent link="link_1_1"/>
    <child link="link_2_1"/>
    <axis xyz="-1.0 0.0 0.0"/>
    <dynamics damping="0.12" friction="0.03"/>
    <xacro:arm_limit lower="${joint_2_lower}" upper="${joint_2_upper}"/>
  </joint>
  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
  <joint name="joint_3" type="${arm_joint_type}">
    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
    <origin rpy="${'2.4000 0 0' if lock_arm else '0 0 0'}" xyz="-0.001077 0.0 0.350077"/>
    <parent link="link_2_1"/>
    <child link="link_3_1"/>
    <axis xyz="1.0 0.0 0.0"/>
    <dynamics damping="0.12" friction="0.03"/>
    <xacro:arm_limit lower="${joint_3_lower}" upper="${joint_3_upper}"/>
  </joint>
  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
  <joint name="joint_4" type="${arm_joint_type}">
    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
    <origin rpy="${'1.0642 0 0' if lock_arm else '0 0 0'}" xyz="0.026 0.0 0.3235"/>
    <parent link="link_3_1"/>
    <child link="link_4_1"/>
    <axis xyz="-1.0 0.0 0.0"/>
    <dynamics damping="0.06" friction="0.02"/>
    <xacro:arm_limit lower="${joint_4_lower}" upper="${joint_4_upper}"/>
  </joint>
  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
  <joint name="joint_5" type="${arm_joint_type}">
    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
    <origin rpy="${'0 0 1.8334' if lock_arm else '0 0 0'}" xyz="-0.0495 0.0 0.04"/>
    <parent link="link_4_1"/>
    <child link="link_5_1"/>
    <axis xyz="0.0 0.0 1.0"/>
    <dynamics damping="0.05" friction="0.02"/>
    <xacro:arm_limit lower="${joint_5_lower}" upper="${joint_5_upper}"/>
  </joint>
  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
  <joint name="joint_6" type="${arm_joint_type}">
    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
    <origin rpy="${'-0.8381 0 0' if lock_arm else '0 0 0'}" xyz="-0.041 0.0 0.0495"/>
    <parent link="link_5_1"/>
    <child link="link_6_1"/>
    <axis xyz="-1.0 0.0 0.0"/>
    <dynamics damping="0.05" friction="0.02"/>
    <xacro:arm_limit lower="${joint_6_lower}" upper="${joint_6_upper}"/>
  </joint>
  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
  <link name="gripper_tcp"/>
  <joint name="gripper_tcp_joint" type="fixed">
    <origin xyz="-0.102 0.0 0.0" rpy="0 0 0"/>
    <parent link="link_6_1"/>
    <child link="gripper_tcp"/>
  </joint>
  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
  <link name="motor_joint_1">
    <inertial>
      <origin rpy="0 0 0" xyz="0 0 0"/>
      <mass value="0.7"/>
      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
    </inertial>
  </link>
  <joint name="motor_joint_1_joint" type="fixed">
    <origin rpy="0 0 0" xyz="0.0 0.0 0.0"/>
    <parent link="arm_base_link_1"/>
    <child link="motor_joint_1"/>
  </joint>
  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
  <link name="motor_joint_2">
    <inertial>
      <origin rpy="0 0 0" xyz="0 0 0"/>
      <mass value="1.6"/>
      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
    </inertial>
  </link>
  <joint name="motor_joint_2_joint" type="fixed">
    <origin rpy="0 0 0" xyz="-0.065 0.0 0.056"/>
    <parent link="link_1_1"/>
    <child link="motor_joint_2"/>
  </joint>
  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
  <link name="motor_joint_3">
    <inertial>
      <origin rpy="0 0 0" xyz="0 0 0"/>
      <mass value="0.7"/>
      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
    </inertial>
  </link>
  <joint name="motor_joint_3_joint" type="fixed">
    <origin rpy="0 0 0" xyz="-0.001077 0.0 0.350077"/>
    <parent link="link_2_1"/>
    <child link="motor_joint_3"/>
  </joint>
  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
  <link name="motor_joint_4">
    <inertial>
      <origin rpy="0 0 0" xyz="0 0 0"/>
      <mass value="0.28"/>
      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
    </inertial>
  </link>
  <joint name="motor_joint_4_joint" type="fixed">
    <origin rpy="0 0 0" xyz="0.026 0.0 0.3235"/>
    <parent link="link_3_1"/>
    <child link="motor_joint_4"/>
  </joint>
  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
  <link name="motor_joint_5">
    <inertial>
      <origin rpy="0 0 0" xyz="0 0 0"/>
      <mass value="0.28"/>
      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
    </inertial>
  </link>
  <joint name="motor_joint_5_joint" type="fixed">
    <origin rpy="0 0 0" xyz="-0.0495 0.0 0.04"/>
    <parent link="link_4_1"/>
    <child link="motor_joint_5"/>
  </joint>
  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
  <link name="motor_joint_6">
    <inertial>
      <origin rpy="0 0 0" xyz="0 0 0"/>
      <mass value="0.28"/>
      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
    </inertial>
  </link>
  <joint name="motor_joint_6_joint" type="fixed">
    <origin rpy="0 0 0" xyz="-0.041 0.0 0.0495"/>
    <parent link="link_5_1"/>
    <child link="motor_joint_6"/>
  </joint>
  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
  <link name="gripper_servo_link">
    <inertial>
      <origin rpy="0 0 0" xyz="0 0 0"/>
      <mass value="0.055"/>
      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
    </inertial>
  </link>
  <joint name="gripper_servo_joint" type="fixed">
    <origin rpy="0 0 0" xyz="-0.036 0.0 0.0"/>
    <parent link="link_6_1"/>
    <child link="gripper_servo_link"/>
  </joint>
  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
  <link name="gripper_imu_link">
    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
    <inertial>
      <mass value="0.001"/>
      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
    </inertial>
    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
  </link>
  <joint name="gripper_imu_joint" type="fixed">
    <origin rpy="0 0 0" xyz="-0.035 0 0"/>
    <parent link="link_6_1"/>
    <child link="gripper_imu_link"/>
  </joint>
  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
  <xacro:property name="gripper_force" value="20.0"/>
  <xacro:property name="gripper_damping" value="400.0"/>
  <joint name="right_finger_joint" type="${prismatic_joint_type}">
    <origin rpy="0 0 0" xyz="-0.0576 -0.0038 0.0135"/>
    <parent link="link_6_1"/>
    <child link="right_finger_link_1"/>
    <axis xyz="0.0 1.0 0.0"/>
    <dynamics damping="${gripper_damping}"/>
    <limit effort="${gripper_force}" lower="-0.007" upper="0.016" velocity="0.05"/>
  </joint>
  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
  <joint name="left_finger_joint" type="${prismatic_joint_type}">
    <origin rpy="0 0 0" xyz="-0.0576 0.0038 -0.0135"/>
    <parent link="link_6_1"/>
    <child link="left_finger_link_1"/>
    <axis xyz="0.0 1.0 0.0"/>
    <xacro:unless value="${lock_arm or arm_control}"><mimic joint="right_finger_joint" multiplier="-1.0" offset="0.0"/></xacro:unless>
    <dynamics damping="${gripper_damping}"/>
    <limit effort="${gripper_force}" lower="-0.016" upper="0.007" velocity="0.05"/>
  </joint>
  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
  <joint name="vertical_lift_joint" type="${prismatic_joint_type}">
    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
    <origin rpy="0 0 0" xyz="-0.06 0.0 ${0.35 if lock_arm else 0.75}"/>
    <parent link="vertical_column_link_1"/>
    <child link="lift_carriage_link_1"/>
    <axis xyz="0.0 0.0 1.0"/>
    <dynamics damping="5.0" friction="2.0"/>
    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
    <limit effort="150" lower="-0.4" upper="0.6" velocity="0.20"/>
  </joint>
  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
  <joint name="left_wheel_joint" type="continuous">
    <origin rpy="0 0 3.141592653589793" xyz="0 ${wheel_joint_y} -0.0068"/>
    <parent link="base_link"/>
    <child link="left_wheel_link_1"/>
    <axis xyz="0.0 -1.0 0.0"/>
    <dynamics damping="0.02" friction="0.0"/>
  </joint>
  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
  <joint name="right_wheel_joint" type="continuous">
    <origin rpy="0 0 3.141592653589793" xyz="0 ${-wheel_joint_y} -0.0068"/>
    <parent link="base_link"/>
    <child link="right_wheel_link_1"/>
    <axis xyz="0.0 -1.0 0.0"/>
    <dynamics damping="0.02" friction="0.0"/>
  </joint>
  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
  <joint name="imu_joint" type="fixed">
    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
    <origin rpy="0 0 0" xyz="0.08 0 0.0532"/>
    <parent link="base_link"/>
    <child link="imu_link_1"/>
  </joint>
  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
  <joint name="front_caster_joint" type="fixed">
    <origin rpy="0 0 3.141592653589793" xyz="0.349 0 0.0106"/>
    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
    <parent link="base_link"/>
    <child link="front_caster_link_1"/>
  </joint>
  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
  <joint name="lidar_joint" type="fixed">
    <origin rpy="0 0 3.141592653589793" xyz="0.35 0 0.250248"/>
    <parent link="base_link"/>
    <child link="lidar_link_1"/>
  </joint>
  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
  <joint name="base_to_vertical_column_joint" type="fixed">
    <origin rpy="0 0 3.141592653589793" xyz="-0.03 0 0.020248"/>
    <parent link="base_link"/>
    <child link="vertical_column_link_1"/>
  </joint>
  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
  <joint name="carriage_to_arm_joint" type="fixed">
    <origin rpy="0 0 0" xyz="-0.0925 0.0 0.0675"/>
    <parent link="lift_carriage_link_1"/>
    <child link="arm_base_link_1"/>
  </joint>
  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
  <link name="laser">
    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
    <inertial>
      <mass value="0.001"/>
      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
    </inertial>
  </link>
  <joint name="laser_joint" type="fixed">
    <origin rpy="0 0 3.141592653589793" xyz="-0.058 0.0 0.030"/>
    <parent link="lidar_link_1"/>
    <child link="laser"/>
  </joint>
  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
  <link name="rear_box_link">
    <inertial>
      <origin rpy="0 0 0" xyz="-0.0600 0 0.5000"/>
      <mass value="2.5718"/>
      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
    </inertial>
    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
  </link>
  <joint name="base_to_rear_box_joint" type="fixed">
    <origin rpy="0 0 0" xyz="0 0 0"/>
    <parent link="base_link"/>
    <child link="rear_box_link"/>
  </joint>
  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
  <link name="herrajes_link">
    <inertial>
      <origin rpy="0 0 0" xyz="0.0454 0.0000 0.2571"/>
      <mass value="1.870"/>
      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
    </inertial>
    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
  </link>
  <joint name="base_to_herrajes_joint" type="fixed">
    <origin rpy="0 0 0" xyz="0 0 0"/>
    <parent link="base_link"/>
    <child link="herrajes_link"/>
  </joint>
  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
  <link name="electronica_link">
    <inertial>
      <origin rpy="0 0 0" xyz="-0.0232 -0.0000 0.4985"/>
      <mass value="0.951"/>
      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
    </inertial>
    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
  </link>
  <joint name="base_to_electronica_joint" type="fixed">
    <origin rpy="0 0 0" xyz="0 0 0"/>
    <parent link="base_link"/>
    <child link="electronica_link"/>
  </joint>
  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
  <link name="base_interior_link">
    <inertial>
      <origin rpy="0 0 0" xyz="0.2124 0.0000 0.0738"/>
      <mass value="3.439"/>
      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
    </inertial>
    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
  </link>
  <joint name="base_to_base_interior_joint" type="fixed">
    <origin rpy="0 0 0" xyz="0 0 0"/>
    <parent link="base_link"/>
    <child link="base_interior_link"/>
  </joint>
  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
  <link name="monitor_link">
    <inertial>
      <origin rpy="0 0 0" xyz="-0.0038 0 0.0014"/>
      <mass value="0.550"/>
      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
    </inertial>
    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
  </link>
  <joint name="base_to_monitor_joint" type="fixed">
    <origin rpy="0 0 0" xyz="-0.070 0 1.135"/>
    <parent link="base_link"/>
    <child link="monitor_link"/>
  </joint>
  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
  <link name="rear_box_panels_link">
    <inertial>
      <origin rpy="0 0 0" xyz="-0.0600 0 0.5000"/>
      <mass value="0.902"/>
      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
    </inertial>
    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
  </link>
  <joint name="rear_box_to_panels_joint" type="fixed">
    <origin rpy="0 0 0" xyz="0 0 0"/>
    <parent link="rear_box_link"/>
    <child link="rear_box_panels_link"/>
  </joint>
  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
  <link name="base_panels_link">
    <inertial>
      <origin rpy="0 0 0" xyz="0.1300 0 0.1150"/>
      <mass value="1.664"/>
      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
    </inertial>
    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
  </link>
  <joint name="base_to_panels_joint" type="fixed">
    <origin rpy="0 0 0" xyz="0 0 0"/>
    <parent link="base_link"/>
    <child link="base_panels_link"/>
  </joint>
  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
  <link name="cabeza_link">
    <inertial>
      <origin rpy="0 0 0" xyz="-0.00048 -0.00049 0.66631"/>
      <mass value="0.8717"/>
      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
    </inertial>
    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
  </link>
  <joint name="columna_to_cabeza_joint" type="fixed">
    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
    <origin rpy="0 0 0" xyz="-0.1392 0 0.6645"/>
    <parent link="vertical_column_link_1"/>
    <child link="cabeza_link"/>
  </joint>

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
<xacro:include filename="$(find andesrobot_description)/urdf/andesrobot.sim.xacro" />

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
<xacro:arg name="use_hardware" default="false"/>
<xacro:arg name="hoverboard_port" default="/dev/hoverboard"/>
<xacro:if value="$(arg use_hardware)">
  <xacro:include filename="$(find andesrobot_description)/urdf/andesrobot.ros2_control.xacro" />
</xacro:if>

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
<xacro:if value="${arm_control and not lock_arm}">
  <xacro:include filename="$(find andesrobot_description)/urdf/andesrobot.arm_control.xacro" />
</xacro:if>
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
<xacro:arg name="gripper_camera" default="false"/>
<xacro:if value="$(arg gripper_camera)">
  <xacro:include filename="$(find andesrobot_description)/urdf/andesrobot.gripper_camera.xacro" />
</xacro:if>

</robot>
