AndesRobot-Oficial/Structure-Embedded-Systems_MILO/(commit log)

2026-11-08 milo_description rev. 1: fusión con estructura/masas de milo_teleop y brazo del equipo garra
    Fusiona tres versiones del modelo:
    - este repo: documentación, args lock_arm / simple_collision / sim_* / use_hardware;
    - milo_teleop: estructura V-slot 3030/6060 con collar de la columna, 74 escuadras + SK16,
    electrónica, baterías, carcasas, cabeza (RealSense D435 + pantalla), brazo sin base redonda
    montado en la placa del carro, masas de piezas reales (36.8 kg, sin lastre);
    - milo_ws rama brazo (equipo garra): args arm_control y gripper_camera, límites por
    articulación, fuerza/amortiguamiento de los dedos, gripper_tcp, sim.xacro, arm_control.xacro
    y gripper_camera.xacro.
    lock_arm:=tr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
    [acrilico_base.stl, andesrobot.arm_control.xacro, andesrobot.gripper_camera.xacro, andesrobot.sim.xacro, andesrobot.urdf.xacro, arduino_mega_metal.stl, arduino_mega_negro.stl, arduino_mega_pcb.stl]
2026-11-08 Actualizar README, BOM y CAD con la información del URDF rev. 1
    - README: dimensiones 56 × 50 × 161 cm, peso ~36,8 kg, estado del URDF, BOM y CAD.
    - BOM: perfilería con largos de corte (10,04 m de 3030 + 1,5 m de 6060, collar de la columna),
    placas de acrílico y PAI, SK16, rueda loca y tornillería de la estructura (74 escuadras,
    anclajes internos); TB6600 a 800 pasos/rev; motor propuesto para J3 (NEMA 23 2,0 N·m).
    - CAD: lista de cambios del URDF rev. 1 que faltan pasar a Fusion.
    - ROBOT.md: componentes del plano eléctrico que aún no están en el URDF.
2026-11-10 CAD y URDF rev. 1 listos: CAD de Fusion igual al URDF y ruedas centradas
    - CAD de Fusion actualizado al URDF rev. 1: bastidor V-slot 3030 con collar,
    caja trasera, columna 6060, escuadras, SK16, acrílico y placas de PAI;
    CAD de fabricante (ruedas de hoverboard, placa del hoverboard, Jetson Orin
    Nano, Arduino Mega, TB6600, regulador 36-12 V, RPLIDAR C1); baterías, IMU,
    rueda loca, monitor y Orbbec; brazo sin base redonda y cabeza contra la
    columna. Materiales y masas del URDF y articulaciones del URDF.
    Nuevo cad/milo_ensamblaje.f3z y STEP reexportado.
    - URDF: el origen de los joints de las ruedas pasa al centro de la llanta;
    wheel_separation (0,3604 m, igual que Navegation_MIL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
    [andesrobot.sim.xacro, andesrobot.urdf.xacro, milo_ensamblaje.f3z, milo_ensamblaje.step]
